amaargiru/mini_wo_iso_m2/sch_pcb/rezonit/Параметры ламели.png

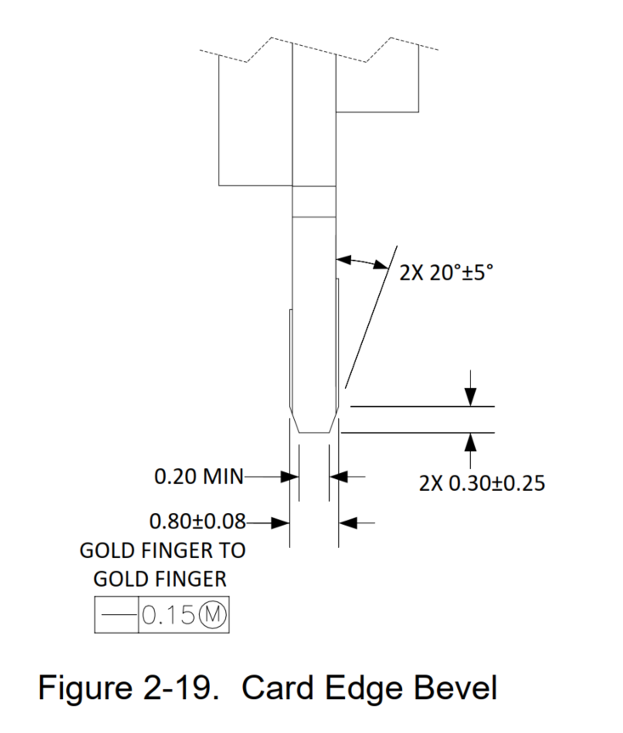
sch_pcb/rezonit/Параметры ламели.png
