amaargiru/mini_wo_iso_m2/sch_pcb/1.pdf

# Интерфейс 10BASE-T1L

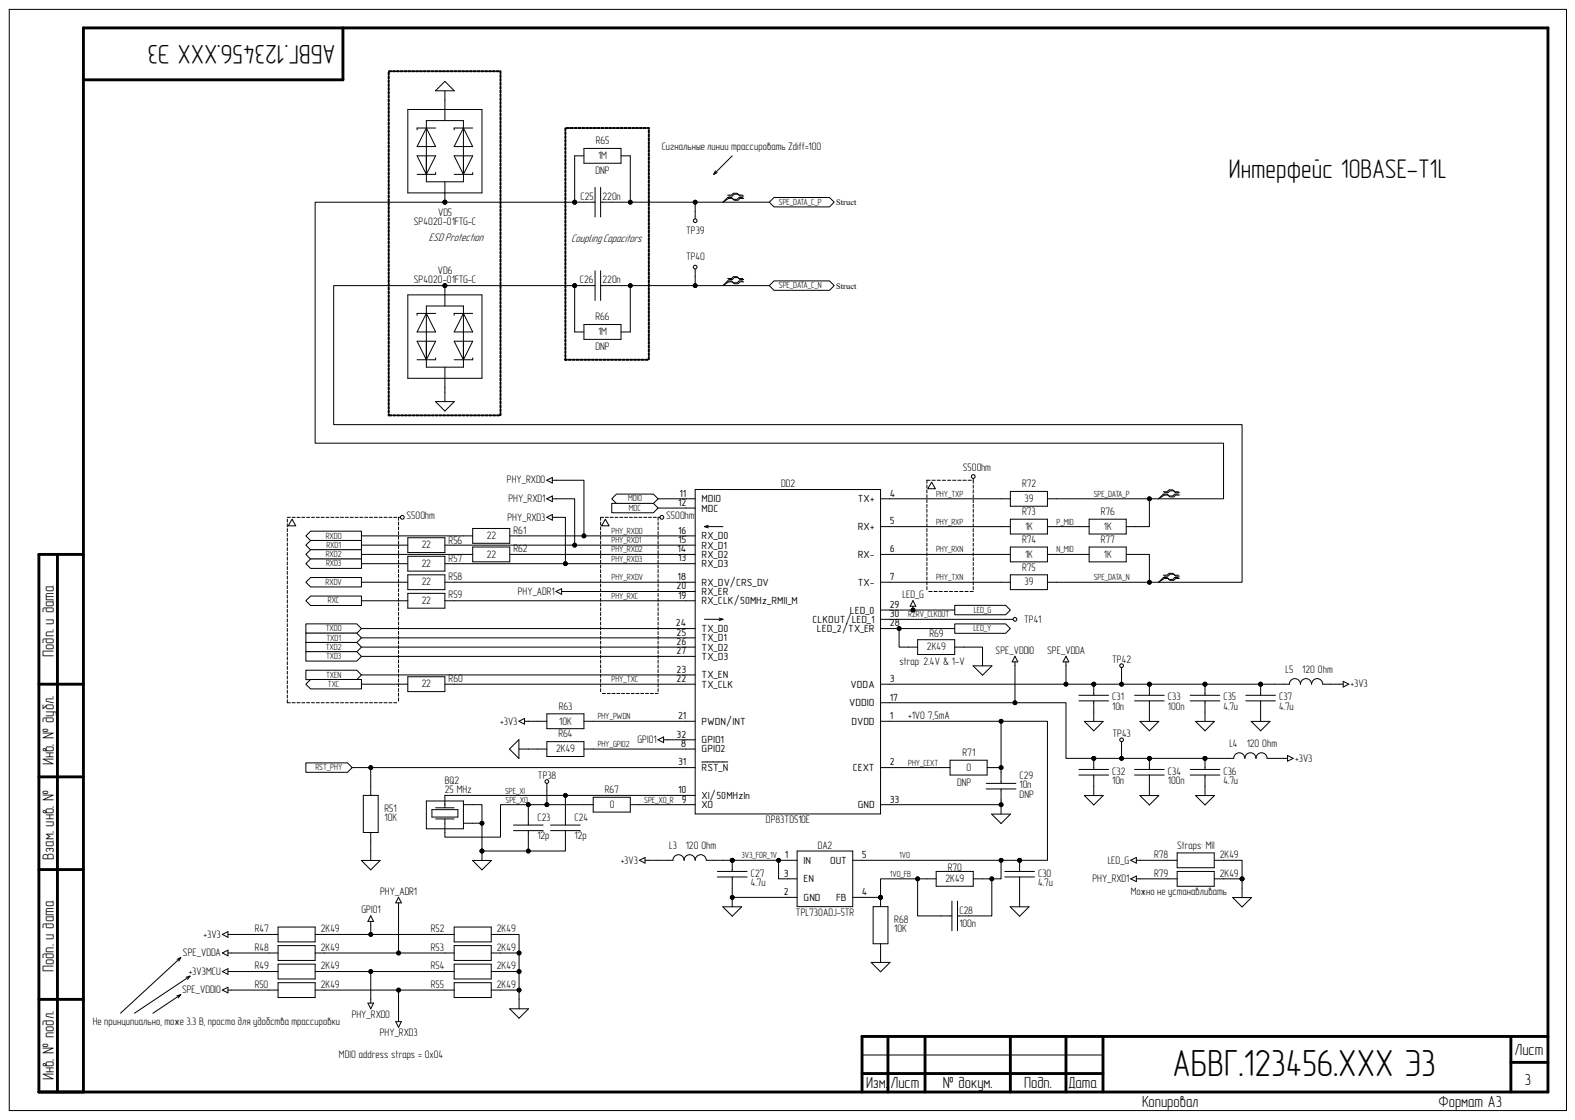
[picture p4: page 1]

Сигнальные линии трассировать Zdiff=100

3 Инв. № подл. Инв. № дубл. Подп. и дата Взам. инв. № Подп. и дата

R59 22 PHY_RXC | RX_CLK/50MHz_RMII_M 19 | TP41

SPE_XO | | 0 | SPE_XO_R | XO 9
C23 | C24

R53 | 2K49
R54 | | 2K49
R55 | 2K49

Не принципиально, тоже 3.3 В, просто для удобства трассировки
