amaargiru/mini_wo_iso_m2/(list of files, drawings)

Other design files:
sch_pcb/PCB/ums.PcbDoc
sch_pcb/SCH/MCU.SchDoc
sch_pcb/SCH/RS-485.SchDoc
sch_pcb/SCH/Struct.SchDoc
sch_pcb/SCH/T1L_PHY.SchDoc
sch_pcb/UMS.PrjPcb
