amaargiru/mini_wo_iso_m2/(commit log)

2026-01-15 Удалил отладочный разъём (контакты JTAG перенёс на боковые полуотверстия)
    [MCU.SchDoc, RS-485.SchDoc, Struct.SchDoc, T1L_PHY.SchDoc, ums.PcbDoc]
2026-01-15 Дневная работа
    [MCU.SchDoc, RS-485.SchDoc, Struct.SchDoc, T1L_PHY.SchDoc]
2026-01-17 Снизил количество ошибок на плате с 659 до 487
    [MCU.SchDoc, Struct.SchDoc]
2026-01-17 Уеньшил количество ошибок DRC PCB до 297
    [RS-485.SchDoc]
2026-01-18 Уменьшил количество ошибок до 229
    [MCU.SchDoc, RS-485.SchDoc, Struct.SchDoc, T1L_PHY.SchDoc]
2026-01-19 Заменил разъём M.2 на B+M
    [MCU.SchDoc, RS-485.SchDoc, Struct.SchDoc, T1L_PHY.SchDoc]
2026-01-19 Снизил количество ошибок до 98
    [RS-485.SchDoc, Struct.SchDoc]
2026-01-19 Сохраняюсь перед изменением RX-TX
    [Bill of Materials-UMS.xlsx, MCU.SchDoc, RS-485.SchDoc, Struct.SchDoc, T1L_PHY.SchDoc, UMS.PrjPcb]
2026-01-19 Снизил количество ошибок до 45
    [MCU.SchDoc, Struct.SchDoc, T1L_PHY.SchDoc]
2026-01-19 Снизил количество ошибок до 11
    [T1L_PHY.SchDoc]
2026-01-20 Выровнял SPI и MDIO
    [MCU.SchDoc, T1L_PHY.SchDoc]
2026-01-20 Выровнял X-Class RXD
    [T1L_PHY.SchDoc, UMS.PrjPcb]
2026-01-20 Выровнял X-Classes TXD
2026-01-20 Более-менее чистовой вариант платы
2026-01-23 Добавил замечания Романа Колоскова
2026-01-23 Исправил часть замечаний Колоскова Романа
    [MCU.SchDoc, RS-485.SchDoc, T1L_PHY.SchDoc]
2026-01-25 Внедрил предложения Романа Колоскова
2026-01-25 Внедрил часть доработок Игоря
    [MCU.SchDoc, Struct.SchDoc, T1L_PHY.SchDoc]
2026-01-26 Добавил все хотелки Игоря Сысоева
    [MCU.SchDoc, RS-485.SchDoc, Struct.SchDoc, T1L_PHY.SchDoc]
2026-02-09 Расчистил немного места слева и справа ПП, чтобы было куда ставить технологические перемычки
    [Bill of Materials-UMS.xlsx, MCU.SchDoc, REZONIT_blank_zakaza.xlsx, Struct.SchDoc, UMS.PrjPcb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]
